flashdato/Bachelor_Project/Media/README.md

# Media — Smart Flow 2.0

This folder contains photos and video demonstrations of the physical prototype.

---

## Contents (to be uploaded)

### Prototype Photos
- `enclosure_overview.jpg` — Full assembly inside IP65 enclosure
- `sensor_module_board.jpg` — STM32 Sensor Module Blue Pill with wiring
- `relay_module_board.jpg` — STM32 Relay Module with 8-channel relay board
- `esp32_wiring.jpg` — ESP32 module and UART connections
- `solenoid_valves.jpg` — Zone solenoid valves installed on irrigation manifold
- `stepper_motor_assembly.jpg` — Fertilizer mixing valve with stepper motor
- `tds_ph_probes.jpg` — TDS and pH probes installed in-line
- `power_system.jpg` — 12V power rails, buck converters, battery

### Video Demonstrations
- `demo_relay_switching.mp4` — All 11 relay channels tested via serial terminal
- `demo_irrigation_sequence.mp4` — Full 13-state irrigation sequence running on bench
- `demo_tds_feedback.mp4` — TDS readings updating in real-time while fertilizer pump adjusts
- `demo_mqtt_control.mp4` — MQTT command from mobile triggering relay via ESP32 → STM32

---

## Photo Guidelines

When adding photos:
- Include a ruler or reference object for scale where possible
- Label boards clearly (sticky label or printed overlay)
- Capture both overview shots and detail close-ups of wiring
- Good lighting — avoid shadows on connector pins

---

## Video Guidelines

- Record serial terminal output alongside hardware where possible
- Keep videos under 2 minutes each
- Add audio commentary or on-screen text labels for what each step demonstrates
