flashdato/Bachelor_Project/Manual_Uploads/README.md

# Manual Uploads — Thesis Document Versions

This folder contains snapshots of the thesis document at different stages of development.

---

## Files

| File | Date | Description |
|---|---|---|
| **[Bachelor_Project.docx](Bachelor_Project.docx)** | June 2026 | **Final submitted version** — complete thesis with abstract, all chapters, tables, code appendices |
| [bachelor project 27.07.2026 test.docx](bachelor%20project%2027.07.2026%20test.docx) | June 2026 | Pre-final formatting test |
| [Bachelor_Project_28.06.2026.docx](Bachelor_Project_28.06.2026.docx) | May 2026 | Late draft — all chapters present, humanization pass complete |
| [Bachelor_Project_07.03.2026.docx](Bachelor_Project_07.03.2026.docx) | March 2026 | Early draft — initial structure and Chapter 1 only |
| [PDF/Bachelor_Project_28.06.2026.pdf](PDF/Bachelor_Project_28.06.2026.pdf) | May 2026 | PDF export of May draft |

---

## Document Structure (Final Version)

- **Abstract** — 300-word project overview
- **Chapter 1 — Introduction** — background, objectives, scope
- **Chapter 2 — Literature Review** — commercial systems, academic prototypes, microcontroller comparison
- **Chapter 3 — System Architecture** — hardware overview, power, communication protocol, sensors, actuators
- **Chapter 4 — Implementation** — Sensor Module firmware, Relay Module firmware, ESP32 design, mobile app, weather engine, fertilizer control
- **Chapter 5 — Testing and Evaluation** — test methodology, TDS accuracy results, communication reliability, cost breakdown, discussion, limitations
- **Conclusion**
- **References** (15 IEEE-format citations)
- **Appendix A** — Sensor Module firmware listings (full source)
- **Appendix B** — Relay Module firmware listings (full source)
- **Appendix C** — ESP32 architecture design specification

---

> The live Google Docs working copy was used during writing. This folder contains the exported final and archived versions.
