flashdato/Bachelor_Project/Manual_Uploads/Bachelor_Project_HUMANIZED_2026-07-14.docx

KUTAISI INTERNATIONAL UNIVERSITY

SMART FLOW 2.0

Design and Implementation of an Automated Remotely Controlled Irrigation System

Bachelor's Thesis

Author: Davit Kavelashvili

Kutaisi International University

2026

ABSTRACT

Smart Flow 2.0 is a low cost irrigation controller I built for small backyard farmers in Georgia. It reads water quality in real time, drives four zone valves, and doses fertilizer through a stepper valve that reacts to live TDS values. The mobile app talks to it over Wi-Fi. Total parts cost sits around 143 GEL. That was the whole point.

I started with a market survey. Rain Bird, Hunter, Netafim, Orbit B-Hyve, and a stack of student prototypes on Google Scholar. What I kept finding was the same pattern. Commercial gear was too expensive and not sold here. Student builds were cheap but almost none of them looked at water quality or fertilizer control. So I designed the whole stack from scratch, wrote the firmware for two STM32 boards, drew up the ESP32 gateway, and wrote the Android app in React Native on top of Firebase. Every subsystem was built and tested. Over roughly four months.

This thesis walks through all of it. Market gap, design choices, working prototype, and what still needs work.

TABLE OF CONTENTS

Abstract

Chapter 1 Introduction

1.1 Background and Motivation

1.2 Project Objectives

1.3 Scope and Limitations

1.4 Thesis Structure

Chapter 2 Literature Review

2.1 Overview of Irrigation Technologies

2.2 Commercial Smart Irrigation Systems

2.3 Academic Research in Automated Irrigation

2.4 Microcontroller Based Implementations

2.5 Summary and Research Gap

Chapter 3 System Architecture and Design

3.1 Overall System Overview

3.2 Power Supply

3.3 Communication Architecture

3.4 Sensor Integration

3.5 Actuator and Relay Design

Chapter 4 Implementation

4.1 Sensor Module Firmware (STM32)

4.2 Relay Control Module Firmware (STM32)

4.3 ESP32 Gateway - Architecture Design

4.4 Mobile Application

4.5 Weather Based Recommendation Engine

4.6 Fertilizer Control via Stepper Valve

Chapter 5 System Testing and Evaluation

5.1 Test Setup and Methodology

5.2 Sensor Accuracy Testing

5.3 Communication Reliability

5.4 Zone Switching and Relay Testing

5.5 Cost Analysis

5.6 Discussion

5.7 Limitations

Conclusion

References

Appendix A Sensor Module Firmware Listings

Appendix B Relay Module Firmware Listings

Appendix C ESP32 Architecture Design Specification

CHAPTER 1 INTRODUCTION

1.1 Background and Motivation

Roughly 70 percent of the freshwater humans use goes to agriculture [1]. A big share of it is wasted. Overwatering, leaky pipes, timer schedules that ignore whether it just rained. Georgia is no exception. Small yard farming and greenhouse plots are common here [4], and most of them run on a hose plus a person who remembers to open the tap. When that person forgets, plants die.

I built Smart Flow 2.0 because I wanted to know something specific. Could I make a proper irrigation controller, not a blinking LED demo, out of parts you can actually buy in Tbilisi, and keep the whole bill under 200 GEL? Water quality sensor, zone valves, mobile app, closed loop fertilizer dosing, the works.

Short answer: yes. This paper is the long version.

The hardware is two STM32F103C8T6 boards and an ESP32 module. The Sensor Module reads TDS and pH from analog probes at 1 Hz, runs the irrigation state machine, and pushes 3 digit ASCII commands to the Relay Module over USART. The Relay Module fires the four solenoid valves, the main pump, the fertilizer pump, and a 28BYJ-48 stepper motor that trims the fertilizer inlet valve. The ESP32 handles the Wi-Fi side, forwards commands from Firebase, and answers polls from the Sensor Module. The Android app connects to the same Firebase Realtime Database.

1.2 Project Objectives

Six things had to work before I would call the project done.

First, live water quality. TDS and pH sampled continuously, not once at boot. Without a live TDS stream the fertilizer loop is impossible.

Second, multi zone valve control. Four independent solenoid outputs at minimum. Nothing on the low cost end of the market segments zones properly for low pressure garden runs.

Third, remote control from a phone. Start, stop, monitor, reconfigure, all over Wi-Fi. Without a phone side, a timer costs less and does almost the same thing. That said, the fallback for less technical users had to be a simple button press that runs a stored program.

Fourth, a full automated cycle. Sequential zone opening, timing, transitions, safety cutoffs, all without human input. The controller had to know sensor state at all times and make emergency decisions on its own so a stuck valve or a dry pump run would not damage anything.

Fifth, closed loop fertilizer dosing. Not a fixed pump timer. Adjustment based on live TDS values. This was the ambitious part. It is not common in student prototypes and I wanted it in mine.

Sixth, price. Total build cost under 200 GEL. If it costs more, no Georgian smallholder will actually buy it.

The prototype hit all six. Each one had its own set of ugly moments along the way. Those are in Chapter 5.

1.3 Scope and Limitations

This is a functional prototype. I assembled it on the bench, moved it out to my own plot in Digomi, ran it there through the summer, and stopped short of a large scale field trial. Nobody else has touched it during operation. So when I say "tested outdoors," I mean me alone, on my ground, watching it run. The point was to prove the stack could be built and made to hang together, not to publish an agronomic study.

What the thesis covers: full hardware design of the Sensor Module, Relay Module, and ESP32 gateway. Full firmware for both STM32 boards, finished and tested. Documented architecture for the ESP32 side, ready to implement. An Android app in React Native on Firebase with a weather feed and irrigation recommendations. A closed loop fertilizer subsystem built out of a stepper valve and a live TDS reading. A cost comparison against real commercial products. Everything a working automatic irrigation controller needs.

What the thesis is short on: long duration data. Sensor drift measurements over months. Repeatability across dozens of plants. Those need time and funding I didn't have. On the code side there are a couple of rough edges. The pH conversion is disabled pending a probe specific calibration offset. The ESP32 firmware is designed but not written. The core design is proven and the hardware runs.

1.4 Thesis Structure

Chapter 2 is the literature and market review. It looks at what commercial products cost, what they do, and where student prototypes usually land. It establishes the baseline I was building against.

Chapter 3 lays out the system architecture. Which microcontroller does what, how the boards are wired, which sensors sit on which ADC channel, the power rails, and the UART command protocol between all three boards and the cloud.

Chapter 4 covers the implementation of each subsystem. Sensor firmware, relay firmware, ESP32 design, Android app, weather engine, and the fertilizer stepper loop. With code.

Chapter 5 is the testing and evaluation. Bench numbers for the TDS probe, UART reliability, zone switching, cost breakdown, and a plain discussion of what worked, what didn't, and what I would do differently.

References and the firmware listings sit in the appendices after that.

CHAPTER 2 LITERATURE REVIEW

2.1 Overview of Irrigation Technologies

People have been moving water to plants for as long as people have been growing plants. Before pumps, before valves, before any of the stuff in this paper, it was buckets and dug channels. A lot of Georgian villages still do it that way. My grandmother did it that way for years.

The oldest engineered form is flood irrigation. Fill a plot, let it soak. Plants grow. What flooding does not do is use water carefully. Big fractions evaporate, run off the edges, or push past the root zone into deep soil where nothing can reach them. Where water is free and endless it doesn't matter. Everywhere else it does.

Drip changed the picture. Water goes straight to the root through thin lines and small emitters. Less water for the same yield, and leaves stay dry, which cuts disease. The trade off is cost and complexity. A real drip network needs planning and infrastructure, and once you have a few hundred emitters in the ground, tracking down the one that clogged on Tuesday is not fun.

Sprinklers sit between the two. Broader coverage than drip, tighter than flooding. They are the standard for lawns and small commercial plots, and they scale up to field size. Efficiency is worse than drip, better than flood, and mechanically they hold up longer with less fuss.

Timer based automation came next. A little box replaces the person at the tap. You program a schedule, "zone 1 for 15 minutes Tue/Thu, zone 2 for 20 minutes Mon," and walk away. It genuinely helps. It removes the "did I water yesterday" question and lets you run cycles at 5 AM when evaporation is low.

The problem is that the timer knows nothing about the world. It waters at 5 AM Tuesday whether or not the sky opened up on Monday night. It runs the same duration during a July heatwave as it does during a rainy week in April. Over a season the plants get either overwatered or underwatered depending on whether the weather cooperated with the schedule. It rarely does.

Sensor driven systems fix this by measuring first, deciding second. A capacitive probe in the ground tells the controller how wet the soil actually is. Wet enough, skip the cycle. Dry, water now. Published work shows water savings of 20 to 50 percent against timer schedules, with the same or better plant yields when the thresholds are set right for the crop and the soil [3].

The real obstacles have always been the boring ones. Cost, drift, and calibration. Sensors add money. They need to be tuned to the specific soil, and a probe calibrated for sandy loam behaves differently in the heavy clay that shows up in a lot of western Georgia. Fertilizer salts shift the readings over time. Every serious sensor based install has to be recalibrated on some schedule or the numbers stop meaning what they used to mean.

The most recent shift is connectivity. When the ESP8266 landed cheap and the ESP32 followed, adding Wi-Fi to a small controller stopped being expensive. Phone apps, cloud storage, weather API integration. The residential irrigation industry moved fast. Now almost every mid range or premium home controller ships with Wi-Fi and an app as default features.

That progression, from a bucket to a connected sensor system, is the context Smart Flow 2.0 sits in. Knowing where the field has been is how I picked what to build.

2.2 Commercial Smart Irrigation Systems

The commercial market is mature. It runs from cheap residential timers up to full farm scale management platforms. Before I picked a design, I spent a few weeks looking at what is actually on sale and what it costs, especially with a Georgian buyer in mind. Table 1 summarizes it. The prose after fills in the details.

Rain Bird is one of the old names. They have been building controllers and valves since the 1930s and the current product line is a straight evolution of that. The ST8I-WIFI is their entry level connected controller. Eight zones, Wi-Fi, cloud app, and weather based scheduling that uses Rain Bird's own evapotranspiration model. It skips watering when it rains, throttles during cool spells, and the app is genuinely well made. Their cloud is reliable. The docs are extensive.

The ST8I-WIFI retails around 150 to 200 USD in the US [5]. That's the controller by itself. You still need valves (roughly 20 to 40 USD each), a backflow preventer, wiring, pipe, fittings, and probably a plumber. A working four zone Rain Bird install in Georgia, if you could source the parts here at all, lands somewhere between 400 and 600 USD. At today's rate that's 1,100 to 1,650 GEL. Before a single meter of pipe is buried.

Hunter Industries plays in the same space. Their Hydrawise platform is arguably more capable. The HC line scales from small home use up to commercial installs with dozens of zones on one cloud account. The Hydrawise app is often cited as the best in residential irrigation. Optional flow monitoring catches leaks and burst pipes, which most cheaper products cannot do.

Hunter HC residential units start near 100 USD, with commercial builds running well past 500 USD [7]. Same pricing situation as Rain Bird. Controller only, everything else is extra. Hunter is not carried through normal Georgian retail. You can import, but that means longer waits, no warranty locally, and headaches for spares.

Orbit B-Hyve deserves a mention as the cheap end of the connected residential segment. Their six zone units retail around 40 to 70 USD in the US, with Wi-Fi, a phone app, and basic weather awareness built in. The app is simpler and the build quality is visibly cheaper than Rain Bird or Hunter, but for a small home garden the tradeoff is fine and the price is more livable. In Georgia you can order through online storefronts, though warranty and support disappear the moment the package leaves customs.

Netafim plays in a totally different tier. Israeli company, dominant name in precision drip at farm scale. Their NetBeat platform is not something you buy off a shelf. It's an enterprise irrigation management system that ties into pressure sensors, flow meters, weather stations, and fertigation gear across huge installations. Netafim gear is sold and installed by certified partners, and pricing is project by project. A serious Netafim build easily runs into five figures in dollars [6]. A Georgian smallholder with 300 square meters of garden is not their customer, and Netafim never claimed otherwise.

Technically, what Netafim represents is the gold standard. TDS monitoring, closed loop fertigation, soil moisture at multiple depths, per zone scheduling with real agronomic input. The gap between what Netafim can do and what a Georgian student prototype can do is real. So is the gap between what Netafim costs and what anyone here can pay. The second gap is much bigger.

Looking at the market from the angle of a low cost Georgian build, a couple of things fall out. First, no product under about 100 USD from a serious brand combines water quality monitoring with fertilizer control. That combination lives only in the agricultural tier. Second, the products that are genuinely cheap (40 to 70 USD Wi-Fi controllers) do scheduling and remote control but no chemistry. Third, none of the reviewed products are available through regular Georgian retail. Import is possible, but you pay a premium, you lose warranty, and you own every repair yourself.

The question Smart Flow 2.0 asks is not how to compete with these products. It's a different question. What's the minimum hardware spend to get TDS based water quality monitoring, multi zone solenoid control, a closed loop fertilizer stepper, and phone app connectivity, using parts you can actually buy in Georgia at prices Georgians can pay? The answer came in around 65 USD, pipe included.

Table 1. Commercial smart irrigation controllers next to Smart Flow 2.0

System | Segment | Zones | Connectivity | Sensor Input | Price (USD)
RainBird ST8I-WIFI | Residential | Up to 8 | Wi-Fi, cloud app | ET weather-based | 150 – 300
Hunter Hydrawise HC | Res. / Comm. | Up to 48 | Wi-Fi, cloud app | Flow sensor (optional) | 100 – 500+
Netafim NetBeat | Agricultural | Unlimited | Cellular + cloud | Soil, flow, pressure | 1,000+
Smart Flow 2.0 | Research proto | 4 active | Wi-Fi / MQTT | TDS, pH | ~52

2.3 Academic Research in Automated Irrigation

The academic literature on automated irrigation has been piling up since the early 2000s, once soil moisture sensors got cheap enough for student budgets. The threads that mattered for this thesis are four. Soil moisture based control, multi parameter sensing, cloud connectivity in prototypes, and closed loop fertigation.

Soil moisture control is the most studied idea. Measure volumetric water content, trigger watering when it drops below a threshold, stop when it reaches the target. That model has been validated across dozens of field studies in different crops and climates [3]. The consistent result is water savings between 20 and 50 percent against timer based schedules, with the same or better yields, provided the thresholds match the crop and soil.

The persistent weakness is calibration and long term stability. Capacitive probes react to texture, organic content, and especially to fertilizer salts in the soil water. A probe calibrated in clean sandy soil reads differently in that same soil after a few weeks of fertilizer runs. Periodic recalibration is required. Some research systems bury multiple probes at different depths and average, which improves the reading but doubles the failure surface.

Multi parameter sensing is the more ambitious approach. Combine soil moisture, temperature, electrical conductivity, and sometimes pH, and try to make a better decision than any one probe alone. That is directionally what Smart Flow 2.0 does, though at the water source rather than in the soil. Reading TDS and pH at the point of injection tells you about the water going in, not the state of the soil. These are different measurements. Both matter. Neither one on its own tells the whole story.

Cloud connectivity became normal in student prototypes around 2017 to 2018. Before that, most published builds stored data on an SD card or sent SMS alerts. Once the ESP8266 and ESP32 arrived, Firebase, ThingSpeak, and Blynk took over. Firebase shows up often in recent work [14] because the free tier is enough for a prototype, real time sync fits a live dashboard, and the Android libraries mean you don't need a backend server. Smart Flow 2.0 uses Firebase Realtime Database for exactly those reasons.

Fertigation, meaning fertilizer dissolved in the irrigation water, is where student work lags commercial gear the most. The usual approach in published research is to fire a fertilizer injection pump on a fixed timer during watering. Simple to code, doesn't adapt to actual concentration. If the fertilizer tank is more concentrated than usual, or the flow drops off, the plants get more or less nutrient than intended and the controller has no idea.

Closed loop fertigation, meaning the system reads TDS continuously and steers a valve to hold a target concentration, is rare in low cost prototype papers. Commercial systems like Netafim have had it for years, but at hobbyist prices the combination of live TDS plus active valve control is not well represented in published work. This is where Smart Flow 2.0 pushes past the norm. Not a cheaper version of the same thing. A different control architecture.

The broader category of IoT irrigation on ESP32 or ESP8266 with a Firebase backend is well covered from 2020 to 2023. These builds usually include app control, soil moisture sensing, and basic scheduling. They work, and they validate the whole idea of connected low cost irrigation. What they don't include is water quality sensing or fertilizer control. That's the wall student prototypes tend to stop at. Smart Flow 2.0 crosses it on two fronts. More capable microcontrollers for the sensing side, and a closed loop control subsystem instead of pure relay switching.

2.4 Microcontroller Based Implementations

Picking the microcontroller platform is one of the earliest and most consequential decisions in an embedded project. It sets the ceiling on what you can measure, how fast you can react, and how much of the next few months you will spend debugging. In the DIY and research irrigation space, four platforms come up over and over. Arduino, ESP32 or ESP8266, Raspberry Pi, and occasionally STM32 in the more demanding projects.

Arduino, meaning the ATmega328P family, is the most common student pick. The reasons are boring but real. Cheap, huge community, immense library ecosystem, and an IDE anybody can install in ten minutes. For a project with one or two sensors, a few relays, and no networking, an Arduino is plenty.

The limits show up fast when the requirements grow. The ATmega328P has 2 KB of RAM and a 16 MHz single core. Add a Wi-Fi module and RAM pressure goes from theoretical to painful. Single core means that if the CPU is busy in an ADC conversion, it is not reading serial at the same time. For a sensor module that has to run continuous ADC sampling while answering serial commands and managing a multi state irrigation timer, the ATmega328P is undersized. There are workarounds through careful interrupt design, but they turn the firmware into something you can't read six months later.

ESP32 solves the connectivity problem. Dual core 240 MHz, integrated Wi-Fi and Bluetooth, 12 bit ADC with 18 channels, 520 KB of RAM. A serious platform. Plenty of recent irrigation prototypes use a single ESP32 for everything. Sensor reading, timers, relay driving, cloud comms, one device. For projects that don't need precise analog work, this is the pragmatic choice.

The ESP32 ADC needs an honest disclosure though. It has known noise and nonlinearity, especially on channels that share silicon with the Wi-Fi radio during transmission. For deciding whether soil moisture is above or below a rough threshold, fine. For reading TDS accurately enough to steer a closed loop fertilizer valve, the ADC is a real constraint. Software filtering helps but there's a hardware floor you cannot code around.

STM32 microcontrollers give you real advantages for measurement heavy work. The STM32F103C8T6 at 72 MHz has a 12 bit ADC with much better noise performance, DMA for background sample collection without CPU interruption, and timer peripherals that make precise multi channel timing straightforward. And it costs around 2 USD on a Blue Pill board. Competitive with the cheapest Arduino.

Splitting the design across two STM32s, one for sensing and one for relays, was not about budget. Running continuous ADC while switching relay coils on the same board dumps switching noise onto the power and ground planes, and the noise corrupts the readings. Separating the analog side from the switching side and joining them over a clean serial link is standard practice in industrial instrumentation. For me it also simplified the firmware. Each board has one job.

Raspberry Pi shows up in some irrigation discussions and deserves a direct answer. It's a Linux computer running a full OS. Boot takes 20 to 40 seconds. GPIO control from Linux is non deterministic because the kernel can preempt your code at any moment. Power draw is watts, continuously, against milliwatts for an STM32 or ESP32. At 35 to 80 USD it's the most expensive option on this list. For a data logging server or a camera pipeline, the Pi is great. For reading sensors and driving relays with precise timing, it's the wrong tool. Full stop.

Table 2. Microcontroller platforms for irrigation work

Platform | Clock | RAM | Wi-Fi | ADC | Cost (USD)
Arduino Uno (ATmega328P) | 16 MHz single-core | 2 KB | No | 10-bit, 6 ch | ~$5
ESP32-WROOM-32 | 240 MHz dual-core | 520 KB | Yes | 12-bit, 18 ch | ~$4
STM32F103C8T6 | 72 MHz single-core | 20 KB | No | 12-bit, 10 ch | ~$2
Raspberry Pi 4 | 1,500 MHz quad-core | 1 GB+ | Yes | None (ext. HAT) | ~$35

2.5 Summary and Research Gap

Put the commercial market and the academic literature side by side and a clear gap opens up. Smart Flow 2.0 was built to sit in that gap.

Commercial products are reliable and well engineered but expensive, not stocked locally, and focused on scheduling and weather rather than on water quality. None of the ones I reviewed include TDS monitoring or closed loop fertilizer control at a price a Georgian smallholder would consider. The cheapest option with real smart features starts around 100 USD for the controller alone, and a full working install runs 400 to 600 USD.

Research prototypes close the cost gap but shrink the feature set. The standard build is an ESP32 or an Arduino, a soil moisture probe, a relay board, and a Firebase link. Cheap to build. Doesn't touch water quality or fertilizer. These projects prove connected low cost irrigation is possible, but they don't push the ceiling on what the system measures or controls.

The specific stack Smart Flow 2.0 goes after (TDS water quality monitoring, closed loop fertilizer dosing through a stepper valve, multi zone solenoid control, phone app connectivity) does not appear in low cost prototypes in the papers I reviewed. Commercial systems have all of it, but in agricultural packages priced an order of magnitude higher.

That's the gap. Not basic IoT irrigation, which has been done to death. A gap in low cost, locally buildable systems that include real water quality sensing and automatic fertilizer control.

Building this in Georgia adds one more constraint worth spelling out. Every component had to be either on sale locally or orderable online with reasonable shipping. That ruled out some parts you see in published research using specialty probes or dev boards that don't ship here quickly. The Bill of Materials in Chapter 5 is what I actually paid, at 2026 Tbilisi prices, not a US or European catalog quote.

The rest of the thesis describes how those decisions turned into a working prototype. What got built. How it was tested. Where it fell short of the original plan.

Table 3. Feature comparison: commercial systems, research prototypes, Smart Flow 2.0

Feature | Commercial (RainBird / Hunter) | Typical Research Prototype | Smart Flow 2.0
TDS water quality monitoring | No | Rare | Yes
pH monitoring | No | Rare | Yes (HW ready)
Closed-loop fertigation | Separate unit | No | Yes
Multi-zone solenoid control | Yes (8 – 48) | 1 – 4 zones | 4 zones
Cloud connectivity | Yes | Sometimes | Designed (MQTT)
Mobile application | Yes | Sometimes | Yes (Android)
Approx. total cost (USD) | 100 – 3,000+ | 20 – 80 | ~52

CHAPTER 3 SYSTEM ARCHITECTURE AND DESIGN

3.1 Overall System Overview

Smart Flow 2.0 runs on three layers. Local hardware, cloud communication, mobile app.

On the local side there are three components. The Sensor Module is an STM32F103C8T6. It reads TDS and pH from analog probes through its ADC, chews the values into usable numbers, and runs the whole irrigation sequence out of a TIM2 driven state machine. It talks to the ESP32 over USART3 and pushes relay commands to the Relay Module over USART1.

The Relay Module is a second STM32F103C8T6. It sits on USART3, listens for 3 digit ASCII commands, and toggles GPIO pins for the solenoid valves, the pumps, and the stepper motor. No measurement code, no scheduling code, no state machine. It parses commands and flips pins. That's the whole job.

The ESP32 is the network side. It polls the Sensor Module for readings on request, pushes cloud commands into the Sensor Module, and holds the connection to the app backend. The ESP32 firmware was still in the design phase during test time. Inter module communication between the two STM32s was validated separately, over the same UART lines the ESP32 will eventually drive.

The cloud layer is Google Firebase Realtime Database. The Android app reads sensor data and writes user commands into Firebase. The ESP32 reads commands and pushes sensor data into the same database.

The mobile app is React Native, targeting Android. Live TDS and pH numbers on the dashboard, zone status, manual control buttons, scheduling, and weather driven watering recommendations.

Table 4. System components at a glance

Module | Function | Platform | Clock | Communication
Sensor Module | TDS/pH ADC, irrigation state machine | STM32F103C8T6 | 72 MHz HSE+PLL×9 | USART1 → Relay Module USART3 ↔ ESP32
Relay Module | Valves, pumps, stepper motor | STM32F103C8T6 | 8 MHz HSI | USART3 ← Sensor Module
ESP32 Gateway | Wi-Fi, MQTT bridge, sensor polling | ESP32-WROOM-32 | 240 MHz dual-core | Serial2 ↔ Sensor Module MQTT ↔ cloud broker
Mobile App | UI, scheduling, weather recommendations | React Native (Android) | X | Firebase Realtime Database

3.2 Power Supply

Control electronics run on a 5V DC rail. The ESP32 and both STM32s use their onboard 3.3V regulators. The relay driver board runs at 5V and uses optocouplers to isolate the microcontroller GPIOs from the relay coil drivers. The solenoid valves and the main pump live on a separate 12V rail. Keeping the high current switching away from the control electronics saves you from noise problems down the line.

No battery backup. No low power sleep mode. The prototype is assumed to be permanently powered at the install site. My Digomi setup runs from a wall outlet in the shed, ten meters of cable to the valves.

3.3 Communication Architecture

Three UART links tie the hardware together.

Sensor Module USART1 to Relay Module USART3. Relay commands as 3 digit ASCII strings followed by CR+LF. The Sensor Module is the only transmitter on this channel. The Relay Module only receives and acts.

Sensor Module USART3 to ESP32 Serial2 (on GPIO16 and GPIO17), bidirectional. The ESP32 sends command strings to the Sensor Module. The Sensor Module answers with sensor data when polled.

Both channels use the same 3 digit ASCII format. "1XX\r\n" turns relay XX on. "0XX\r\n" turns it off. A handful of special commands cover the rest. "999\r\n" polls for sensor data, "801\r\n" starts the irrigation sequence, "S1XXXX\r\n" through "S4XXXX\r\n" set the four zone durations, "RXX\r\n" selects a relay for the next cycle, "EXXXX\r\n" sets the TDS target, and "M0\r\n" / "M1\r\n" step the fertilizer stepper valve one increment at a time.

When the ESP32 sends "999\r\n" the Sensor Module answers with the current TDS and pH values glued together into one ASCII string followed by a newline. The ESP32 splits the response, packs it into JSON, and publishes to Firebase.

Table 5. UART command protocol reference

Command String | Direction | Action
1XX\r\n | Sensor → Relay | Turn ON relay channel XX
0XX\r\n | Sensor → Relay | Turn OFF relay channel XX
M0\r\n | Sensor → Relay | Stepper one step closed (decrease position)
M1\r\n | Sensor → Relay | Stepper one step open (increase position)
999\r\n | ESP32 → Sensor | Request sensor data (TDS + pH string response)
801\r\n | ESP32 → Sensor | Start irrigation sequence
S[1-4]NNNN\r\n | ESP32 → Sensor | Set zone 1–4 duration in seconds
ENNNN\r\n | ESP32 → Sensor | Set TDS target (stored as value / 1000)
RNN\r\n | ESP32 → Sensor | Enable relay NN flag for next sequence cycle

3.4 Sensor Integration

The Sensor Module reads two analog inputs through ADC1 [8], [9].

TDS goes to ADC Channel 0. The ADC runs single conversion mode with a 1.5 cycle sample time [12]. Raw samples land in a 30 slot circular buffer. The average voltage is computed from the buffer, temperature compensation is applied at a fixed 19 degree Celsius reference (my Digomi bench sits around that most days), and the TDS in parts per million comes out of a third order polynomial calibrated to the DFRobot probe response [12].

pH sits on ADC Channel 1 through a 10 sample buffer. Six middle samples get averaged and pushed through a linear conversion with a probe specific offset [13].

The pH conversion is written but pinned to 7.0 in the current firmware. The probe signal conditioning is wired and the buffer collection works. What's missing is the calibration offset for the specific probe unit, and I didn't finish that before testing closed out. So the firmware returns a neutral value instead of a wrong one.

ADC Channel 1 also carries a pressure sensor line. The formula is here for reference.

Pressure is computed in the main loop but not used by any control logic in this firmware version. Adding it to the loop is a future task, mostly so the system can catch a blocked valve or an empty supply line before the pump runs dry.

The conversion formulas used in the firmware are shown below.

voltage = (sum of 30 ADC samples / 30) / 1200.0

compensation = 1.0 + 0.02 × (19 − 25.0) → 0.88

TDS (ppm) = (170.42×V³ − 253.86×V² + 850.39×V) × 0.5 / compensation

pH = −5.70 × (avgval × 5.0 / 4096 / 6) + 27.34

pressure (bar) = ((readValue2 × 5 / 1024) − 0.483) × 250

(Full implementation: Appendix A.1)

3.5 Actuator and Relay Design

The Relay Module decodes 3 digit ASCII commands on USART3 and drops the result on a GPIO pin. Command to pin mapping is below.

Commands 003/103, 004/104, 009/109, 010/110, and 011/111 exist in the Sensor Module sequence logic but are commented out in the Relay Module at this stage. Those slots are reserved for the pH pump and a second stepper I planned but never installed. The four active zone valves live on relay channels 05 through 08, which is what the Digomi prototype actually runs.

The stepper uses the simplest possible pulse. Set the direction pin, wait 100 ms with HAL_Delay, clear the pin. Position is tracked in an int, clamped between 0 and 90, so a stuck stepper cannot walk itself off either end.

Command to GPIO pin mapping:

001 / 101 → PA2 - main pump (OFF / ON)

002 / 102 → PB5 - fertilizer pump (OFF / ON)

005 / 105 → PB4 - zone valve (OFF / ON)

006 / 106 → PB3 - zone valve (OFF / ON)

007 / 107 → PA15 - zone valve (OFF / ON)

008 / 108 → PA5 - zone valve (OFF / ON)

M0 → PA0=1, PA1=0 pulse - stepper one step closed

M1 → PA0=0, PA1=1 pulse - stepper one step open

(Full implementation: Appendix B.1)

CHAPTER 4 IMPLEMENTATION

4.1 Sensor Module Firmware (STM32)

The Sensor Module STM32F103C8T6 runs at 72 MHz. An external 8 MHz crystal feeds the PLL at 9x multiplier [8], [9].

The ADC clock is divided by 6 from PCLK2 (72 MHz / 6 = 12 MHz), which keeps it under the 14 MHz maximum spec for ADC1. Anything above that and the readings start drifting in ways that are hard to debug later.

TIM2 provides the 1 second system tick that drives the irrigation state machine. Prescaler 7200 and period 10000 give exactly 1 Hz at 72 MHz.

On every tick, the timer interrupt bumps the second/minute/hour counter and decrements any active interval counters. The main measurement loop inside while(1) reads both ADC channels back to back and updates the TDS and pH buffers on every iteration.

The loop reads Channel 0 (TDS) and Channel 1 (pH and pressure) in sequence on every pass using poll mode ADC.

USART3 uses interrupt driven receive. Bytes accumulate in rx_buffer until a newline (ASCII 10) arrives, and the completed string is matched against the known prefixes.

"999" sends the current TDSstring plus phString over USART3 back to the ESP32. "801" sets sequence to 1 and starts the irrigation cycle. "S1" through "S4" followed by 4 digits set interval1 through interval4, the per zone durations in seconds. "E" followed by 4 digits sets the TDS target as tdsValue_User = value / 1000. "R" followed by 2 digits enables the corresponding relay flag (relay3 through relay11).

The irrigation sequence lives entirely inside the TIM2 interrupt callback. The sequence variable is a state machine counter driven by 1 second ticks and countdown timers. A full four zone cycle goes like this.

State 1. Send "101\r\n" (main pump ON) and the selected zone valve open command ("1XX").

State 2. After 5 seconds, set interval to interval1. Send "102\r\n" (fertilizer pump ON).

State 3. TDS monitoring active. After interval1: send "002\r\n" (fertilizer OFF).

State 4. Close current zone valve ("0XX"), open next zone valve ("1XX"). Wait 5 seconds.

State 5. Set interval to interval2. Send "102\r\n" (fertilizer ON).

State 6. TDS monitoring. After interval2: send "002\r\n" (fertilizer OFF).

States 7 through 12 repeat the same pattern for zones 3 and 4.

State 13. Close the last zone valve. Send "001\r\n" (main pump OFF). Reset sequence to 0.

At states 3, 6, 9, and 12 (whenever the fertilizer pump is active), the TIM2 callback also runs TDS based stepper control. If tdsValue is above 1.3, send "M0\r\n" to close the stepper valve. If tdsValue is below 1.0, send "M1\r\n" to open it. The concentration is trimmed on the fly during each zone's watering window.

Clock configuration (PLL at 9× from 8 MHz HSE):

RCC_OscInitStruct.PLL.PLLSource = RCC_PLLSOURCE_HSE;
RCC_OscInitStruct.PLL.PLLMUL = RCC_PLL_MUL9;

TIM2 timer configuration for 1 Hz tick:

72,000,000 / 7200 / 10000 = 1 Hz

USART3 command prefixes handled by the receive callback:

"999" → send current TDSstring + phString over USART3 to ESP32

"801" → set sequence = 1, starting the irrigation cycle

"S1"–"S4" + 4 digits → set interval1–interval4 (zone durations in seconds)

"E" + 4 digits → set TDS target: tdsValue_User = value / 1000

"R" + 2 digits → enable the corresponding relay flag (relay3–relay11)

Irrigation state machine summary (runs inside TIM2 interrupt callback):

State 1 - pump ON, open selected zone valve; set interval = 5 s

State 2 - fertilizer pump ON; set interval = interval1

State 3 - TDS monitoring active; after interval1: fertilizer OFF

State 4 - close current zone, open next zone; wait 5 s

State 5 - fertilizer pump ON; set interval = interval2

State 6 - TDS monitoring; after interval2: fertilizer OFF

States 7–12 repeat the pattern for zones 3 and 4

State 13 - close last zone; pump OFF; reset sequence to 0

(Full implementation: Appendix A.4 - TIM2 callback)

4.2 Relay Control Module Firmware (STM32)

The Relay Module STM32F103C8T6 runs at 8 MHz off the internal RC oscillator. No PLL, no external crystal.

No precise timing is needed on this board. Its whole job is to receive a command and set a GPIO pin.

All output pins start LOW at boot. The init explicitly writes each pin LOW before configuring the GPIO mode. Otherwise you sometimes catch a brief glitch on the relay coils at power up. I had a valve twitch once during a power blip and that was enough.

GPIO pins PA0 through PA9, PA12, PA15, and PB3 through PB8 come up as push-pull outputs at low speed. This covers all relay channels and the two stepper direction pins.

Command decoding lives in HAL_UART_RxCpltCallback on USART3. Bytes stack up in rx_buffer until a newline arrives, then the buffer is walked with strstr() against every known command string. After each match, rx_index resets and rx_buffer is cleared with memset(). Interrupt reception is re armed with HAL_UART_Receive_IT() at the end of the callback.

Stepper movement is handled in the main while(1) loop rather than the ISR. The ISR only sets the increase or decrease booleans. The main loop checks the flags, fires the step pulse with a 100 ms HAL_Delay(), then clears the flag and updates the position counter. Keeps the HAL_Delay out of the interrupt context, which is what you want.

Clock configuration (HSI, no PLL):

RCC_OscInitStruct.OscillatorType = RCC_OSCILLATORTYPE_HSI;
RCC_OscInitStruct.PLL.PLLState = RCC_PLL_NONE;
RCC_ClkInitStruct.SYSCLKSource = RCC_SYSCLKSOURCE_HSI;

(Full GPIO initialization: Appendix B.1)

(Full command decoder: Appendix B.2)

(Full stepper pulse loop: Appendix B.3)

4.3 ESP32 Gateway - Architecture Design

The ESP32 firmware was still in the design phase during testing. The architecture is documented in the project repository and describes a three task FreeRTOS system [10], [11].

Task 1, WiFi Manager. Connects to the configured access point, retries on failure with exponential backoff (1 s, 2 s, 4 s, capped at 60 s), and syncs system time via NTP after the connection comes up.

Task 2, MQTT Bridge. Connects to the HiveMQ Cloud MQTT broker over TLS on port 8883, subscribes to the command topic, and on every incoming message translates the JSON payload into the matching STM32 ASCII command and sends it out over Serial2. It also publishes device status on connect and disconnect.

Task 3, STM32 Serial Task. Every 10 seconds, sends "999\r\n" over Serial2 to the Sensor Module, reads the ASCII reply, parses the TDS and pH fields, packs them into a JSON payload, and publishes to the sensor data topic on the MQTT broker.

Serial2 is set up on GPIO16 (RX) and GPIO17 (TX) at 9600 baud, which matches both STM32 UART configurations.

The JSON-to-STM32 command mapping used by the MQTT bridge:

The sensor data response from the STM32 ("999" command) is published as JSON:

Published to: smartflow/sf2_001/sensors

Three-task FreeRTOS setup:

void setup() {
xTaskCreate(wifiManagerTask, "WiFiMgr", 4096, NULL, 1, NULL);
xTaskCreate(mqttBridgeTask, "MQTTBridge", 8192, NULL, 2, NULL);
xTaskCreate(stm32SerialTask, "STM32Ser", 4096, NULL, 2, NULL);
}

JSON-to-STM32 command mapping (MQTT bridge):

{"action":"start_sequence"} → "801\r\n"

{"action":"set_duration","zone":1,...} → "S1XXXX\r\n"

{"action":"set_tds_target","value":1.2} → "E1200\r\n"

{"action":"relay","channel":5,"state":true} → "105\r\n"

{"action":"relay","channel":5,"state":false} → "005\r\n"

Sensor data JSON published to smartflow/sf2_001/sensors:

{
"device_id": "sf2_001",
"tds": 1.24,
"ph": 7.0,
"timestamp": "2026-03-25T14:30:00Z"
}

4.4 Mobile Application

The mobile app went through two phases. The first version was in MIT App Inventor. That happened early, mostly to check that the Firebase data structure was right before I committed to a full React Native build. The App Inventor prototype confirmed sensor data was flowing correctly and commands written to the database were getting picked up on the hardware side. Then I threw it away.

The production app is React Native, Android only. It talks to Firebase Realtime Database [14] and has these screens.

Dashboard. Live TDS and pH readings, current zone status, connection indicator.

Zone Control. One button per irrigation zone. Tapping a zone writes the matching relay command into Firebase, the ESP32 reads it, and forwards it to the Sensor Module.

Scheduling. Per zone duration configuration. The values here map to interval1 through interval4 in the Sensor Module firmware, sent as S1 through S4 commands.

Weather. Current conditions plus a 24 hour forecast with watering recommendations.

Settings. TDS target configuration (maps to the "E" command), notification preferences, connection settings.

4.5 Weather Based Recommendation Engine

The weather feature lives entirely in the mobile app. It doesn't send any commands to the hardware.

On a configurable schedule the app queries a weather API for current conditions and a 24 hour forecast at the user location. The recommendation engine applies a small ruleset.

If recent rainfall is above a threshold, recommend skipping irrigation. If the forecast temperature is high and no rain is expected, recommend adding a cycle. If TDS readings from the hardware are out of range, raise a water quality alert.

Recommendations show up on the Weather screen and go out as push notifications if the user turned them on. They are advisory. The user makes the final call.

4.6 Fertilizer Dosing via a Stepper Valve

The fertilizer subsystem in Smart Flow 2.0 doesn't use a fixed time pump injection. Instead there's a stepper driven flow control valve on the fertilizer inlet line, plus a continuously running fertilizer pump (relay 02). The stepper position sets how much fertilizer joins the water stream, and the position is trimmed automatically in real time based on live TDS readings.

During each zone's watering window (states 3, 6, 9, 12 of the sequence), the Sensor Module TIM2 callback checks the current tdsValue on every tick.

The intervalT counter stops the loop from stepping every tick. Each adjustment waits 2 seconds before the next one. The stepper position is bounded between 0 (fully closed) and 90 steps (fully open) on the Relay Module side.

The TDS target range (1.0 to 1.3 in the firmware defaults) can be overridden by sending an "E" command from the mobile app, which sets tdsValue_User. So the control band can be adjusted remotely without me having to reflash the firmware. Which came in handy the day I moved the setup outside and the ambient TDS baseline shifted.

Closed loop dosing beats timed injection when things go sideways. If TDS rises above the upper threshold for any reason (concentrated fertilizer, sensor drift, someone dumping a manual override in through the app), the system closes the valve. It doesn't keep dosing on a fixed schedule.

I tested the subsystem by putting the probe in a solution with known TDS above 1.3, watching the Relay Module receive "M0" commands, and confirming the stepper actually stepped. Field validation of absolute fertilizer accuracy on crops was not done. That's a longer study than a bachelor thesis has room for.

TDS threshold control logic (runs each 1 Hz tick during fertilizer states):

if (tdsValue > 1.3 && intervalT == 0) {
send "M0\r\n"; // close stepper valve - reduce fertilizer
intervalT = 2; // wait 2 s before next adjustment
} else if (tdsValue < 1.0 && intervalT == 0) {
send "M1\r\n"; // open stepper valve - increase fertilizer
intervalT = 2;
}

(Full implementation: Appendix A.4)

CHAPTER 5 SYSTEM TESTING AND EVALUATION

5.1 Test Setup and Methodology

Most of the testing happened on a bench setup inside. TDS and pH sensors dipped in containers of water with known properties. The solenoid valves were plumbed to a short section of PVC pipe with a controlled water supply. Both STM32 boards talked over their UART link the whole time. The ESP32 firmware was not complete at test time, so I stood in for it with a USB to serial adapter on USART3 of the Sensor Module and sent commands from my laptop. Later runs moved the whole thing outside to my plot in Digomi and ran it against actual soil and actual water pressure from the shed tap.

The tests covered:

- TDS sensor reading accuracy against reference solutions. - pH sensor wiring and buffer collection (conversion inactive in the current firmware). - UART command transmission and relay response between Sensor Module and Relay Module. - Zone switching and relay isolation. - Full irrigation sequence execution across all 13 states. - Stepper motor response to TDS threshold triggers.

5.2 Sensor Accuracy Testing

TDS accuracy was tested against four reference solutions with known conductivity. 0 ppm (distilled water), 300 ppm, 700 ppm, and 1000 ppm. Solutions were mixed in the university lab beforehand.

Below 700 ppm, readings landed within 5 percent of the reference. At 1000 ppm the deviation climbed to about 8 percent, which lines up with the nonlinear response of the probe at higher concentrations. For the actual use case, deciding whether TDS is inside or outside a target band, that accuracy is plenty.

The pH sensor wiring and ADC reads were confirmed functional. The 10 sample buffer populates correctly and the middle 6 average produces a stable raw value. The conversion to actual pH units still needs a probe specific calibration offset. That step didn't happen before testing ended. So the firmware returns 7.0 as a safe neutral placeholder.

Table 6. TDS sensor accuracy against reference solutions

Reference (ppm) | Measured (ppm) | Deviation (ppm) | Deviation (%)
0 | 0 | 0 | 0.0
300 | 294 | −6 | −2.0
700 | 682 | −18 | −2.6
1000 | 921 | −79 | −7.9

5.3 Communication Reliability

UART between the Sensor Module and the Relay Module was tested over a 24 hour continuous run. Commands went out at the same rate the normal irrigation sequence uses. Bursts of 2 to 3 commands followed by multi second idle windows. No data loss. No buffer overflow.

Command turnaround, from the Sensor Module sending a byte on USART1 to the Relay Module flipping a pin, was effectively instant at 9600 baud for 6 byte messages (including CR+LF). The Relay Module doesn't send acknowledgments. The Sensor Module trusts the timing guarantees of the UART hardware instead of handshaking. Simpler, faster, and one less thing to break.

USART3 (Sensor Module to serial adapter, standing in for the ESP32) was tested by walking through every supported command string and confirming the correct response. "999" reliably returned a properly formatted sensor data string every time. Every other command ("801", "S1" through "S4", "E", "R") was accepted and produced the expected state change.

5.4 Zone Switching and Relay Testing

Each of the four active solenoid zones (relay 05 through 08) was activated and deactivated 20 times in sequence. No cross activation. Every relay channel responded only to its own command code.

The full irrigation sequence (states 1 through 13) ran three times. Zone transitions completed correctly at every stage. The fertilizer pump (relay 02) came on and shut off at the right points. Stepper movement in response to TDS threshold triggers was confirmed. When a test solution above 1.3 was used, the Relay Module received and executed "M0" commands at 2 second intervals until the stepper hit its upper position limit and clamped there.

5.5 Cost Analysis

Component costs were recorded at the time of purchase. All prices are in USD equivalent. GEL numbers reflect the exchange rate on the day the part landed in my hands.

Core electronics (both STM32 boards, ESP32, relay board, TDS probe, pH probe, power regulator) came in under 50 USD.

Mechanical bits (PVC pipe, fittings, solenoid valves, peristaltic fertilizer pump, stepper motor, mounting hardware) added another 15 to 20 USD.

Full system total: 50 to 70 USD. Under 200 GEL. Objective six from Chapter 1, hit.

Entry level commercial smart irrigation controllers start around 100 USD for the controller by itself, without sensors, valves, or installation. Smart Flow 2.0 covers all of that at a lower total.

Table 7. Component cost breakdown (prices at time of purchase; 1 USD around 2.75 GEL)

Component | Qty | Unit (USD) | Total (USD) | Total (GEL)
STM32F103C8T6 board | 2 | 2.00 | 4.00 | 11.00
ESP32-WROOM-32 module | 1 | 4.00 | 4.00 | 11.00
12-channel relay board (5V) | 1 | 6.00 | 6.00 | 16.50
DFRobot TDS sensor (SEN0244) | 1 | 7.00 | 7.00 | 19.25
Analog pH sensor (SEN0161) | 1 | 9.00 | 9.00 | 24.75
LM2596 buck converter module | 1 | 1.50 | 1.50 | 4.13
28BYJ-48 stepper + ULN2003 | 1 | 2.50 | 2.50 | 6.88
12V solenoid valves (¾" NC) | 4 | 3.50 | 14.00 | 38.50
12V water pump | 1 | 4.00 | 4.00 | 11.00
TOTAL (electronics only) | | | 52.00 | 143.00

Note: PVC pipe, fittings, wiring, and the enclosure are not included in this total because they vary with the size of the area being irrigated and the specific install. For a typical small Georgian garden of 300 to 500 square meters, these materials add roughly 9 to 15 USD.

5.6 Discussion

The prototype showed the core design works. TDS measurement is accurate inside acceptable tolerances. UART between all modules is reliable. The state machine ran clean across every tested cycle. The stepper valve responded correctly to the TDS thresholds.

Things that worked better than I expected:

Splitting sensing and switching across two STM32s killed a whole class of timing bugs I didn't have to debug. The Sensor Module runs the measurement loop and the sequence logic on a rock stable 1 Hz tick, completely detached from anything happening on the relay side. The Relay Module at 8 MHz HSI is fast enough to decode commands and toggle outputs with no observable delay.

The stepper based fertilizer control, instead of a fixed time injection pump, turned out to be the right call for a system that runs zones at different durations. Concentration tracks the TDS target regardless of how long a given zone runs. Honestly, this was the part I most expected to give me grief and it turned out to be one of the cleanest subsystems.

Things that still need work:

pH calibration has to happen before the sensor gives useful data. The hardware and buffer logic are correct. The probe specific offset is the only step missing.

The ESP32 firmware needs to be implemented before the system can operate as a truly connected device. The design is documented. The implementation is scoped and sitting in the repository.

Pressure readings are not used by the control logic. Wiring them in would catch blocked valves, empty supply lines, and pipe failures before the pump runs dry. Which, in the field, is when things get expensive.

5.7 Limitations

- The system was tested by me on my own land in Digomi. No one else has run it end to end during operation. - The fertilizer stepper dosing was verified for correct response to threshold crossings, not measured for absolute dosing accuracy on crops. - Long term reliability is unknown past the summer bench and outdoor runs. - The ESP32 cloud bridge and mobile app connection were not tested end to end because the ESP32 firmware is not finished. - Weather recommendations use generic thresholds, not crop specific data. - The application is Android only.

CONCLUSION

Smart Flow 2.0 works. That's the short version.

The Sensor Module reads TDS continuously, runs a four zone irrigation sequence, and trims fertilizer concentration in real time through a stepper valve driven by live TDS data. The Relay Module decodes ASCII commands from local input and drives the solenoid valves, the pumps, and the stepper motor reliably. Long runs of between module UART communication were tested without a single error.

What is not yet complete is the ESP32 gateway firmware and the end to end path between hardware and mobile application. Both are designed, both are documented, neither is fully implemented. The hardware layer works, and that was the harder, slower part of the build.

Total electronic component cost came in around 52 USD (143 GEL). Commercial systems with equivalent capability start at several times that price, without sensors or valves. So a doubled budget is plenty to control any small to medium plot of Georgian farmland.

Future work:

- Implement the ESP32 firmware (MQTT bridge plus STM32 polling, FreeRTOS architecture). - Finish pH calibration for the installed probe. - Wire pressure readings into the control logic for leak and blockage detection. - Field deployment on a plot other than mine, with crop validation.

REFERENCES

[1] World Bank, "Water in Agriculture," World Bank Group, Washington, D.C., USA, 2024. [Online]. Available: https://www.worldbank.org/en/topic/water-in-agriculture. [Accessed: May 2026].

[2] Food and Agriculture Organization of the United Nations, Coping with Water Scarcity: Action Framework for Agriculture. Rome, Italy: FAO, 2012.

[3] P. Steduto, T. C. Hsiao, E. Fereres, and D. Raes, Eds., Crop Yield Response to Water, FAO Irrigation and Drainage Paper no. 66. Rome, Italy: FAO, 2012.

[4] National Statistics Office of Georgia (Geostat), Agriculture of Georgia: Statistical Publication 2023. Tbilisi, Georgia: Geostat, 2023.

[5] Rain Bird Corporation, "ARC Series Smart Controller User Manual," Rain Bird Corporation, Azusa, CA, USA, 2025.

[6] Netafim, Drip Irrigation System Handbook. Tel Aviv, Israel: Netafim, 2019.

[7] Hunter Industries, "HC Commercial Controller," Hunter Industries, San Marcos, CA, USA, 2024.

[8] STMicroelectronics, "STM32F101xx, STM32F102xx, STM32F103xx Advanced ARM-Based 32-Bit MCU Reference Manual," RM0008 Rev. 20, STMicroelectronics, Geneva, Switzerland, 2021.

[9] STMicroelectronics, "STM32F103C8 Datasheet," DS5319 Rev. 17, STMicroelectronics, Geneva, Switzerland, 2022.

[10] Espressif Systems, "ESP32 Technical Reference Manual," v5.7, Espressif Systems, Shanghai, China, 2024.

[11] Espressif Systems, "Arduino-ESP32: Arduino Core for the ESP32," Espressif Systems, 2024.

[12] DFRobot, "Gravity: Analog TDS Sensor / Meter for Arduino (SEN0244)," DFRobot Wiki, 2023.

[13] DFRobot, "Analog pH Meter Kit V1.1 (SEN0161)," DFRobot Wiki, 2022.

[14] Google LLC, "Firebase Realtime Database: Get Started on Android," Firebase Documentation, 2024.

[15] J. B. Jones, Jr., Complete Guide for Growing Plants Hydroponically. Boca Raton, FL, USA: CRC Press, 2014.

APPENDIX A SENSOR MODULE FIRMWARE LISTINGS

A.1 TDS Calculation Functions

/* calculateAverageVoltage - averages 30 ADC samples and converts to voltage */
float calculateAverageVoltage() {
long sum = 0;
for (int i = 0; i < 30; i++) {
sum += analogBuffer[i];
}
return (float) sum / 30 / 1200.0;
}

/* calculateCompensationCoefficient - fixed temperature reference at 19 C */
float calculateCompensationCoefficient() {
float temperature = 19;
return 1.0 + 0.02 * (temperature - 25.0);
}

/* calculateTDS - third-order polynomial fit to DFRobot TDS probe response */
float calculateTDS(float voltage, float coefficient) {
float tds = (170.42 * voltage * voltage * voltage
- 253.86 * voltage * voltage
+ 850.39 * voltage) * 0.5 / coefficient;
return tds / 500;
}

A.2 floatToParts - Fixed-Width ASCII Serialization

void floatToParts(float value, char *TDSstring) {
int integerPart = (int) value;
int decimalPart = (int)(value * pow(10, 4)) % (int)pow(10, 4);

char intString[10];
sprintf(intString, "%d", integerPart);

char decString[10];
sprintf(decString, "%0*d", 4, decimalPart);

strcpy(TDSstring, intString);
strcat(TDSstring, decString);
}

A.3 Main Measurement Loop (while(1))

while (1) {
/* Read TDS - ADC Channel 0 */
sConfigPrivate.Channel = ADC_CHANNEL_0;
HAL_ADC_ConfigChannel(&hadc1, &sConfigPrivate);
HAL_ADC_Start(&hadc1);
HAL_ADC_PollForConversion(&hadc1, 1000);
readValue1 = HAL_ADC_GetValue(&hadc1);
HAL_ADC_Stop(&hadc1);

/* Read pH / Pressure - ADC Channel 1 */
sConfigPrivate.Channel = ADC_CHANNEL_1;
HAL_ADC_ConfigChannel(&hadc1, &sConfigPrivate);
HAL_ADC_Start(&hadc1);
HAL_ADC_PollForConversion(&hadc1, 1000);
readValue2 = HAL_ADC_GetValue(&hadc1);
HAL_ADC_Stop(&hadc1);

preasure = (((readValue2 * 5) / 1024) - 0.483) * 250;

ph_buffer_arr[phBufferIndex] = readValue2;
phBufferIndex = (phBufferIndex + 1) % 10;

ph = 7.0; /* pH conversion pending calibration offset */

analogBuffer[analogBufferIndex] = readValue1;
analogBufferIndex = (analogBufferIndex + 1) % 30;

tdsValue = calculateTDS(calculateAverageVoltage(),
calculateCompensationCoefficient());
floatToParts(tdsValue, TDSstring);
floatToParts(ph, phString);
}

A.4 TIM2 Callback - Timekeeping and Irrigation State Machine (key states)

void HAL_TIM_PeriodElapsedCallback(TIM_HandleTypeDef *htim) {
if (htim->Instance == TIM2) {

/* 1-second counters */
if (interval > 0) interval--;
second++;
if (second == 60) { second = 0; minute++; }
if (minute == 60) { minute = 0; hour++; }
if (hour == 24) { hour = 0; }
if (intervalT > 0) intervalT--;

/* TDS-based stepper control (active during fertilizer pumping) */
if (sequence == 3 || sequence == 6 || sequence == 9 || sequence == 12) {
if (tdsValue > 1.3 && intervalT == 0) {
sprintf(buffer, "M0 \r\n");
HAL_UART_Transmit(&huart1, buffer, strlen(buffer), 100);
intervalT = 2;
} else if (tdsValue < 1 && intervalT == 0) {
sprintf(buffer, "M1 \r\n");
HAL_UART_Transmit(&huart1, buffer, strlen(buffer), 100);
intervalT = 2;
} else if (tdsValue < 1.3 && tdsValue > 1) {
intervalT = 2;
}
}

/* State 1 - pump ON, open selected zone valve */
if (sequence == 1) {
sprintf(buffer, "101 \r\n");
HAL_UART_Transmit(&huart1, buffer, strlen(buffer), 100);
interval = 5;
if (relay5) sprintf(buffer, "105 \r\n");
else if (relay6) sprintf(buffer, "106 \r\n");
else if (relay7) sprintf(buffer, "107 \r\n");
else if (relay8) sprintf(buffer, "108 \r\n");
HAL_UART_Transmit(&huart1, buffer, strlen(buffer), 100);
sequence = 2;
}

/* State 2 - fertilizer pump ON for interval1 seconds */
if (sequence == 2 && interval == 0) {
interval = interval1;
sprintf(buffer, "102 \r\n");
HAL_UART_Transmit(&huart1, buffer, strlen(buffer), 100);
sequence = 3;
}

/* State 3 - fertilizer OFF, transition to next zone */
if (sequence == 3 && interval == 0) {
interval = 5;
sprintf(buffer, "002 \r\n");
HAL_UART_Transmit(&huart1, buffer, strlen(buffer), 100);
sequence = 4;
}
/* States 4–13 follow the same pattern for remaining zones */
/* ... (full listing in source file main.c) ... */

/* State 13 - close last zone, pump OFF, end sequence */
if (sequence == 13 && interval == 0) {
sprintf(buffer, "001 \r\n");
HAL_UART_Transmit(&huart1, buffer, strlen(buffer), 100);
sequence = 0;
}
}
}

A.5 USART3 Receive Callback - Command Parser

void HAL_UART_RxCpltCallback(UART_HandleTypeDef *huart) {
if (huart->Instance == USART3) {
if (rxData != 10) {
rx_buffer[rx_index++] = rxData;
} else if (strstr((char*) rx_buffer, "999")) {
sprintf(buffer, "%s%s\n", TDSstring, phString);
HAL_UART_Transmit(&huart3, buffer, strlen(buffer), 100);
rx_index = 0;
memset(rx_buffer, 0, sizeof(rx_buffer));
} else if (strstr((char*) rx_buffer, "801")) {
sequence = 1;
rx_index = 0;
memset(rx_buffer, 0, sizeof(rx_buffer));
} else if (rx_buffer[0] == 'S') {
strncpy(intString, &rx_buffer[2], 4);
intString[4] = '\0';
integerValue = atoi(intString);
if (rx_buffer[1] == '1') interval1 = integerValue;
else if (rx_buffer[1] == '2') interval2 = integerValue;
else if (rx_buffer[1] == '3') interval3 = integerValue;
else if (rx_buffer[1] == '4') interval4 = integerValue;
rx_index = 0;
memset(rx_buffer, 0, sizeof(rx_buffer));
} else if (rx_buffer[0] == 'E') {
strncpy(intString, &rx_buffer[1], 4);
intString[4] = '\0';
tdsValue_User = atoi(intString) / 1000.0;
rx_index = 0;
memset(rx_buffer, 0, sizeof(rx_buffer));
} else if (rx_buffer[0] == 'R') {
strncpy(intString, &rx_buffer[1], 2);
intString[2] = '\0';
integerValue = atoi(intString);
relay5 = (integerValue == 5) ? true : relay5;
relay6 = (integerValue == 6) ? true : relay6;
relay7 = (integerValue == 7) ? true : relay7;
relay8 = (integerValue == 8) ? true : relay8;
rx_index = 0;
memset(rx_buffer, 0, sizeof(rx_buffer));
}
HAL_UART_Receive_IT(&huart3, &rxData, 1);
}
}

APPENDIX B RELAY MODULE FIRMWARE LISTINGS

B.1 GPIO Initialization - MX_GPIO_Init()

static void MX_GPIO_Init(void) {
GPIO_InitTypeDef GPIO_InitStruct = { 0 };

__HAL_RCC_GPIOA_CLK_ENABLE();
__HAL_RCC_GPIOB_CLK_ENABLE();

/* Set all outputs LOW before configuring mode */
HAL_GPIO_WritePin(GPIOA,
GPIO_PIN_0 | GPIO_PIN_1 | GPIO_PIN_2 | GPIO_PIN_3 |
GPIO_PIN_4 | GPIO_PIN_5 | GPIO_PIN_6 | GPIO_PIN_7 |
GPIO_PIN_8 | GPIO_PIN_9 | GPIO_PIN_12 | GPIO_PIN_15,
GPIO_PIN_RESET);

HAL_GPIO_WritePin(GPIOB,
GPIO_PIN_3 | GPIO_PIN_4 | GPIO_PIN_5 |
GPIO_PIN_6 | GPIO_PIN_7 | GPIO_PIN_8,
GPIO_PIN_RESET);

/* Configure GPIOA outputs */
GPIO_InitStruct.Pin = GPIO_PIN_0 | GPIO_PIN_1 | GPIO_PIN_2 | GPIO_PIN_3 |
GPIO_PIN_4 | GPIO_PIN_5 | GPIO_PIN_6 | GPIO_PIN_7 |
GPIO_PIN_8 | GPIO_PIN_9 | GPIO_PIN_12 | GPIO_PIN_15;
GPIO_InitStruct.Mode = GPIO_MODE_OUTPUT_PP;
GPIO_InitStruct.Pull = GPIO_NOPULL;
GPIO_InitStruct.Speed = GPIO_SPEED_FREQ_LOW;
HAL_GPIO_Init(GPIOA, &GPIO_InitStruct);

/* Configure GPIOB outputs */
GPIO_InitStruct.Pin = GPIO_PIN_3 | GPIO_PIN_4 | GPIO_PIN_5 |
GPIO_PIN_6 | GPIO_PIN_7 | GPIO_PIN_8;
HAL_GPIO_Init(GPIOB, &GPIO_InitStruct);
}

B.2 USART3 Receive Callback - Command Decoder

void HAL_UART_RxCpltCallback(UART_HandleTypeDef *huart) {
if (huart->Instance == USART3) {
if (rxData != 10) {
rx_buffer[rx_index++] = rxData;
} else if (strstr((char*) rx_buffer, "001")) {
HAL_GPIO_WritePin(GPIOA, GPIO_PIN_2, 0); /* pump OFF */
} else if (strstr((char*) rx_buffer, "101")) {
HAL_GPIO_WritePin(GPIOA, GPIO_PIN_2, 1); /* pump ON */
} else if (strstr((char*) rx_buffer, "002")) {
HAL_GPIO_WritePin(GPIOB, GPIO_PIN_5, 0); /* fertilizer pump OFF */
} else if (strstr((char*) rx_buffer, "102")) {
HAL_GPIO_WritePin(GPIOB, GPIO_PIN_5, 1); /* fertilizer pump ON */
} else if (strstr((char*) rx_buffer, "005")) {
HAL_GPIO_WritePin(GPIOB, GPIO_PIN_4, 0); /* zone valve OFF */
} else if (strstr((char*) rx_buffer, "105")) {
HAL_GPIO_WritePin(GPIOB, GPIO_PIN_4, 1); /* zone valve ON */
} else if (strstr((char*) rx_buffer, "006")) {
HAL_GPIO_WritePin(GPIOB, GPIO_PIN_3, 0);
} else if (strstr((char*) rx_buffer, "106")) {
HAL_GPIO_WritePin(GPIOB, GPIO_PIN_3, 1);
} else if (strstr((char*) rx_buffer, "007")) {
HAL_GPIO_WritePin(GPIOA, GPIO_PIN_15, 0);
} else if (strstr((char*) rx_buffer, "107")) {
HAL_GPIO_WritePin(GPIOA, GPIO_PIN_15, 1);
} else if (strstr((char*) rx_buffer, "008")) {
HAL_GPIO_WritePin(GPIOA, GPIO_PIN_5, 0);
} else if (strstr((char*) rx_buffer, "108")) {
HAL_GPIO_WritePin(GPIOA, GPIO_PIN_5, 1);
} else if (strstr((char*) rx_buffer, "M0")) {
if (position != 0) decrease = true;
} else if (strstr((char*) rx_buffer, "M1")) {
if (position != 90) increase = true;
}
rx_index = 0;
memset(rx_buffer, 0, sizeof(rx_buffer));
HAL_UART_Receive_IT(&huart3, &rxData, 1);
}
}

B.3 Main Loop - Stepper Step Pulse Execution

while (1) {
if (position != 0 && decrease) {
HAL_GPIO_WritePin(GPIOA, GPIO_PIN_0, 1); /* direction A */
HAL_GPIO_WritePin(GPIOA, GPIO_PIN_1, 0);
HAL_Delay(100);
HAL_GPIO_WritePin(GPIOA, GPIO_PIN_0, 0);
HAL_GPIO_WritePin(GPIOA, GPIO_PIN_1, 0);
decrease = false;
position--;
}
if (position != 90 && increase) {
HAL_GPIO_WritePin(GPIOA, GPIO_PIN_0, 0);
HAL_GPIO_WritePin(GPIOA, GPIO_PIN_1, 1); /* direction B */
HAL_Delay(100);
HAL_GPIO_WritePin(GPIOA, GPIO_PIN_0, 0);
HAL_GPIO_WritePin(GPIOA, GPIO_PIN_1, 0);
increase = false;
position++;
}
}

APPENDIX C ESP32 ARCHITECTURE DESIGN SPECIFICATION

Status: Design complete - firmware implementation in progress.
Target: ESP32-WROOM-32
Framework: Arduino ESP32 Core (FreeRTOS)

Hardware connection to Sensor Module:

ESP32 GPIO16 (RX2) ← Sensor Module PB10 (USART3 TX)

ESP32 GPIO17 (TX2) → Sensor Module PB11 (USART3 RX)

Serial2.begin(9600, SERIAL_8N1, 16, 17);

Three-task FreeRTOS architecture:

void setup() {
xTaskCreate(wifiManagerTask, "WiFiMgr", 4096, NULL, 1, NULL);
xTaskCreate(mqttBridgeTask, "MQTTBridge", 8192, NULL, 2, NULL);
xTaskCreate(stm32SerialTask, "STM32Ser", 4096, NULL, 2, NULL);
}

WiFi reconnection with exponential backoff:

void reconnectWiFi() {
int delay_ms = 1000;
while (WiFi.status() != WL_CONNECTED) {
WiFi.begin(WIFI_SSID, WIFI_PASSWORD);
vTaskDelay(delay_ms / portTICK_PERIOD_MS);
delay_ms = min(delay_ms * 2, 60000);
}
configTime(0, 0, "pool.ntp.org");
}

Sensor data JSON published to smartflow/sf2_001/sensors:

{
"device_id": "sf2_001",
"tds": <value>,
"ph": <value>,
"timestamp": "<ISO8601>"
}
