flashdato/Bachelor_Project/Manual_Uploads/Bachelor_Project_07.03.2026.docx

# Smart Irrigation Systems: Global Market, Competitors, and Technical Architecture

### I. Global Market Overview

The global smart irrigation market is currently characterized by robust growth and technological transformation. As of 2025, the market is valued between $2.14 billion and $2.54 billion. It is projected to continue this upward trajectory, reaching approximately $4.15 billion by 2030 and potentially $8.44 billion by 2034. This expansion represents a compound annual growth rate (CAGR) ranging from 14.1% to 14.28%.

Key Market Drivers: The primary catalyst for this market is the global response to climate change. Smart irrigation is viewed as a critical tool for sustainability, allowing the agricultural and landscaping sectors to optimize water use amid shifting temperature patterns and unpredictable precipitation. Increasing global awareness of water conservation and the rising cost of water utilities are further accelerating adoption. In many regions, nearly 50% of water used in traditional irrigation is lost to inefficiency, creating a significant economic incentive for smart transitions.

Regional Dynamics: North America is currently the largest regional market, driven by early adoption of precision agriculture and the presence of large-scale commercial farming operations. However, the Asia-Pacific region is identified as the area with the most significant future growth potential. This is due to rapid urbanization, the development of smart cities, and an urgent need for sustainable irrigation solutions in response to inadequate rainfall.

Barriers and Challenges: Despite the positive outlook, the market faces hurdles. High initial installation costs remain a barrier for smaller agricultural producers. Furthermore, global trade relations and tariffs are impacting the supply chain, specifically increasing the costs of imported electronic components like sensors and controllers.

### II. Competitive Landscape

The competitive environment is a mix of long-standing irrigation giants and agile tech firms focusing on IoT and AI integration.

Top Tier Global Players: The market is dominated by several key corporations that provide end-to-end hardware and software ecosystems:

- Rain Bird Corporation: A leader in central control systems, specifically with their IQ4 platform, which offers cloud connectivity and modularity.
- The Toro Company: Known for integrating autonomous robotics into its portfolio.
- Netafim: A pioneer in drip irrigation and "nutrigation," focusing on uniform water and nutrient delivery.
- Hunter Industries: A major provider of controllers and sensor technology for both residential and commercial applications.
- HydroPoint: A key player focusing on weather-based data and smart water management.

Strategic Consolidation and M&A: The industry is seeing frequent mergers and acquisitions as companies seek to bolster their AgTech portfolios. Notable developments include Lindsay Corporation's acquisition of FieldWise to strengthen its subscription-based precision irrigation offerings and Toro's acquisition of Left Hand Robotics to advance autonomous maintenance solutions.

Major and Innovative Companies: Other significant contributors include Rachio, AquaSpy, Weathermatic, Calsense, and Galcon. These firms often lead in niche innovations, such as soil moisture sensing probes or consumer-friendly WiFi controllers.

### III. Global Technical Insights

Smart irrigation technology is divided into two primary system types based on how they calculate watering requirements.

1. System Architectures

- Weather-Based (Climate-Based) Systems: These systems use evapotranspiration (ET) data to manage schedules. They analyze local temperature, humidity, wind, and solar radiation to determine how much water has been lost by the landscape and must be replaced.
- Sensor-Based Systems: These rely on real-time data from the ground. Soil moisture sensors measure the volumetric water content or tension in the soil, allowing the system to trigger irrigation only when moisture levels fall below a specific threshold.

2. The AI and IoT Revolution: The market is currently being revolutionized by AI-driven systems that move beyond reactive watering to predictive management. Advanced platforms now integrate environmental sensors with artificial intelligence to autonomously monitor soil, crop, and climatic conditions. For example, modern platforms like Rocket 2.0 deliver real-time management that minimizes waste by predicting needs before they occur.

3. Connectivity and Communication Protocols: For IoT development, selecting the right communication protocol is vital:

- LoRaWAN: This is a leading standard for agricultural IoT. It is optimized for battery-powered end-devices and uses a "star-of-stars" topology where gateways relay messages from remote sensors to a central network server.
- WiFi and Cloud: Many modern controllers (like the Rain Bird RC2) use WiFi for residential and commercial applications, allowing users to manage schedules via mobile apps and receive automatic seasonal adjustments based on local weather data.
- SDI-12: This remains a standard serial-digital interface for environmental sensors, facilitating the connection of diverse soil moisture probes to a single data logger or controller.
- APIs: Platforms like IQ4 now offer API integration, allowing irrigation data to be repurposed for third-party work orders and business reporting.

### IV. Core Components for IoT Prototypes

Building a smart irrigation prototype requires integrating several hardware layers:

Sensors

- Soil Moisture Probes: Technologies include TDT (Time Domain Transmission) and capacitance-type sensors (e.g., Ech2o). These measure the dielectric constant of the soil to determine water content.
- Tensiometers: Measure the physical tension roots must exert to extract water, providing a direct measure of water availability.
- Flow and Pressure Sensors: Critical for system health monitoring, detecting leaks, and ensuring the system is operating within its designed hydraulic range.

Controllers: The controller acts as the brain, processing sensor data or weather inputs to trigger valves. Modern units feature modularity, allowing for the addition of extra zones and the management of master valves and pump start relays.

Infrastructure and Delivery

- Dripperlines: These are the delivery mechanisms. "Smart" drippers often include pressure-compensating (PC) mechanisms to ensure uniform flow regardless of elevation changes, and anti-siphon (AS) features to prevent soil ingestion in subsurface systems.
- Solenoid Valves: Hydraulically operated valves that open and close in response to electrical signals from the controller.

### V. Operational Roadmap for Prototype Development

For a project focused on building an IoT prototype, the following logic and maintenance standards should be incorporated:

Calculation Logic: Implement the daily water requirement formula: EVTc = EVTo * Kc.

- EVTo is the reference evapotranspiration (derived from weather data).
- Kc is the crop coefficient, a variable that changes based on the specific crop and its growth stage (germination, vegetative, maturity).

Hydraulic Safety: A professional prototype must account for "water hammer" and surges. This involves using check valves to prevent backflow (especially when injecting nutrients) and air release valves to evacuate air pockets that can damage pipes.

Maintenance Automation: Incorporate automated flushing cycles. Modern systems are designed to flush main lines and dripperlines at regular intervals to remove mineral sedimentation and organic buildup, which is the leading cause of system failure.

Nutrigation Capability: Consider the integration of a dosing unit. Smart systems don't just deliver water; they deliver precise ratios of nutrients (proportional fertigation) based on the current flow rate, often monitored through EC (electrical conductivity) and pH sensors.
