flashdato/Bachelor_Project/Firmware/CubeIDE_Workspaces/Smart Flow 2.0 Sensor Module/Core/Src/main.c

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
/* Includes ------------------------------------------------------------------*/
#include "main.h"

/* USER CODE BEGIN Includes */
#include "string.h"
#include "stdio.h"
#include <stdbool.h>
#include <math.h>
/* USER CODE END Includes */

ADC_HandleTypeDef hadc1;

TIM_HandleTypeDef htim2;

UART_HandleTypeDef huart1;
UART_HandleTypeDef huart3;

/* USER CODE BEGIN PV */
uint8_t rxData;

//Bluetooth
uint8_t rxData;
uint8_t rx_buffer[100] = { 0 };
uint8_t rx_index = 0;
int len;
char buffer[100];

//sensors
uint16_t readValue1;
uint16_t readValue2;
ADC_ChannelConfTypeDef sConfigPrivate = { 0 };

//TDS
int analogBuffer[30];
int analogBufferIndex = 0;
float tdsValue = 0;
char TDSstring[5];
float tdsValue_User = 0;
int tdsIntervalM = 0;
int tdsInt = 0;

//Preasure
float preasure = 0;
char preasureString[5];

//PH
float ph = 0;
char phString[5];
float calibration_value = 27.34;
int phval = 0;
unsigned long int avgval;
int ph_buffer_arr[10], temp;
int phBufferIndex = 0;

//Time
int second, minute, hour;
int interval, interval1, interval2, interval3, interval4, intervalT;

//Sequence
int sequence = 0;

char intString[5];
int integerValue;

//RELAYS
bool relay1;
bool relay2;
bool relay3;
bool relay4;
bool relay5;
bool relay6;
bool relay7;
bool relay8;
bool relay9;
bool relay10;
bool relay11;

/* USER CODE END PV */

void SystemClock_Config(void);
static void MX_GPIO_Init(void);
static void MX_ADC1_Init(void);
static void MX_USART1_UART_Init(void);
static void MX_USART3_UART_Init(void);
static void MX_TIM2_Init(void);
/**
 * @brief  The application entry point.
 * @retval int
 */
int main(void) {
	/* USER CODE BEGIN 1 */
	float calculateAverageVoltage() {
		long sum = 0;
		for (int i = 0; i < 30; i++) {
			sum += analogBuffer[i];
		}
		return (float) sum / 30 / 1200.0;
	}

	float calculateCompensationCoefficient() {
		float temperature = 19;  // Default temperature (adjust as needed)
		return 1.0 + 0.02 * (temperature - 25.0);
	}

	float calculateTDS(float voltage, float coefficient) {
		float tds = (170.42 * voltage * voltage * voltage
				- 253.86 * voltage * voltage + 850.39 * voltage) * 0.5
				/ coefficient;
		return tds / 500; // Adjust this factor as needed
	}
	void floatToParts(float value, char *TDSstring) {
		int integerPart = (int) value;
		int decimalPart = (int) (value * pow(10, 4)) % (int) pow(10, 4);

		// Convert the integer part to a string
		char intString[10];
		sprintf(intString, "%d", integerPart);

		// Convert the decimal part to a string
		char decString[10];
		sprintf(decString, "%0*d", 4, decimalPart);

		// Combine the integer and decimal parts into TDSstring
		strcpy(TDSstring, intString);
		strcat(TDSstring, decString);
	}
	float readPhSensor() {
//		for (int i = 0; i < 9; i++) {
//			for (int j = i + 1; j < 10; j++) {
//				if (buffer_arr[i] > buffer_arr[j]) {
//					temp = buffer_arr[i];
//					buffer_arr[i] = buffer_arr[j];
//					buffer_arr[j] = temp;
//				}
//			}
//		}

		avgval = 0;
		for (int i = 2; i < 8; i++)
			avgval += ph_buffer_arr[i];

		return -5.70 * avgval * 5.0 / 4096 / 6 + calibration_value;

	}
	/* USER CODE END 1 */

	/* MCU Configuration--------------------------------------------------------*/

	/* Reset of all peripherals, Initializes the Flash interface and the Systick. */
	HAL_Init();

	/* Configure the system clock */
	SystemClock_Config();

	/* Initialize all configured peripherals */
	MX_GPIO_Init();
	MX_ADC1_Init();
	MX_USART1_UART_Init();
	MX_USART3_UART_Init();
	MX_TIM2_Init();
	/* USER CODE BEGIN 2 */
	HAL_TIM_Base_Start_IT(&htim2);
	HAL_UART_Receive_IT(&huart1, &rxData, 1);
	HAL_UART_Receive_IT(&huart3, &rxData, 1);
	/* USER CODE END 2 */

	/* Infinite loop */
	/* USER CODE BEGIN WHILE */
	while (1) {
		sConfigPrivate.Rank = ADC_REGULAR_RANK_1;
		sConfigPrivate.SamplingTime = ADC_SAMPLETIME_1CYCLE_5;
		sConfigPrivate.Channel = ADC_CHANNEL_0;
		HAL_ADC_ConfigChannel(&hadc1, &sConfigPrivate);
		HAL_ADC_Start(&hadc1);
		HAL_ADC_PollForConversion(&hadc1, 1000);
		readValue1 = HAL_ADC_GetValue(&hadc1);
		HAL_ADC_Stop(&hadc1);
		sConfigPrivate.Channel = ADC_CHANNEL_1;
		HAL_ADC_ConfigChannel(&hadc1, &sConfigPrivate);
		HAL_ADC_Start(&hadc1);
		HAL_ADC_PollForConversion(&hadc1, 1000);
		readValue2 = HAL_ADC_GetValue(&hadc1);
		HAL_ADC_Stop(&hadc1);

		preasure = (((readValue2 * 5) / 1024) - 0.483) * 250;

		ph_buffer_arr[phBufferIndex] = readValue2;
		phBufferIndex = (phBufferIndex + 1) % 10;

		//ph = readPhSensor(); //ar gvinda memgoni aq gadaqceva ha ras ityv?
		ph = 7.0;

		analogBuffer[analogBufferIndex] = readValue1;
		analogBufferIndex = (analogBufferIndex + 1) % 30;

		tdsValue = calculateTDS(calculateAverageVoltage(),
				calculateCompensationCoefficient());
		floatToParts(tdsValue, TDSstring);
		//floatToParts(preasure, preasureString);
		floatToParts(ph, phString);
		if (tdsValue_User > 1) {
			tdsValue_User = -1;
		}
		/* USER CODE END WHILE */

		/* USER CODE BEGIN 3 */
	}
	/* USER CODE END 3 */
}

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
/* USER CODE BEGIN 4 */
void HAL_TIM_PeriodElapsedCallback(TIM_HandleTypeDef *htim) {
	if (htim->Instance == TIM2) {
		if (interval > 0) {
			interval--;
		}
		second++;
		if (second == 60) {
			second = 0;
			minute++;
		}
		if (minute == 60) {
			minute = 0;
			hour++;
		}
		if (hour == 24) {
			hour = 0;
		}

		if (intervalT > 0) {
			intervalT--;
		}

		if (sequence == 3 || sequence == 6 || sequence == 9 || sequence == 12) {
			if (tdsValue > 1.3 && intervalT == 0) {
				sprintf(buffer, "M0 \r\n");
				len = strlen(buffer);
				HAL_UART_Transmit(&huart1, buffer, len, 100);
				intervalT = 2;
			} else if (tdsValue < 1 && intervalT == 0) {
				sprintf(buffer, "M1 \r\n");
				len = strlen(buffer);
				HAL_UART_Transmit(&huart1, buffer, len, 100);
				intervalT = 2;
			} else if (tdsValue < 1.3 && tdsValue > 1) {
				intervalT = 2;
			}
		}

		if (sequence == 1) {
			sprintf(buffer, "101 \r\n");
			len = strlen(buffer);
			HAL_UART_Transmit(&huart1, buffer, len, 100);
			sprintf(buffer, "101 \r\n");
			len = strlen(buffer);
			HAL_UART_Transmit(&huart1, buffer, len, 100);
			interval = 5;
			if (relay3) {
				sprintf(buffer, "103 \r\n"); // Format the string for relay3 == true
			} else if (relay4) {
				sprintf(buffer, "104 \r\n"); // Format the string for relay4 == true
			} else if (relay5) {
				sprintf(buffer, "105 \r\n"); // Format the string for relay5 == true
			} else if (relay6) {
				sprintf(buffer, "106 \r\n"); // Format the string for relay6 == true
			} else if (relay7) {
				sprintf(buffer, "107 \r\n"); // Format the string for relay7 == true
			} else if (relay8) {
				sprintf(buffer, "108 \r\n"); // Format the string for relay8 == true
			} else if (relay9) {
				sprintf(buffer, "109 \r\n"); // Format the string for relay9 == true
			} else if (relay10) {
				sprintf(buffer, "110 \r\n"); // Format the string for relay10 == true
			} else if (relay11) {
				sprintf(buffer, "111 \r\n"); // Format the string for relay11 == true
			}
			len = strlen(buffer);
			HAL_UART_Transmit(&huart1, buffer, len, 100);
			sequence = 2;
		}
		if (sequence == 2 && interval == 0) {
			interval = interval1;
			sprintf(buffer, "102 \r\n");
			len = strlen(buffer);
			HAL_UART_Transmit(&huart1, buffer, len, 100);
			sequence = 3;
		}
		if (sequence == 3 && interval == 0) {
			interval = 5;
			sprintf(buffer, "002 \r\n");
			len = strlen(buffer);
			HAL_UART_Transmit(&huart1, buffer, len, 100);
			len = strlen(buffer);
			sequence = 4;
		}
		if (sequence == 4 && interval == 0) {
			interval = 5;
			if (relay3) {
				sprintf(buffer, "003 \r\n"); // Format the string for relay3 == true
				relay3 = false;
			} else if (relay4) {
				sprintf(buffer, "004 \r\n"); // Format the string for relay4 == true
				relay4 = false;
			} else if (relay5) {
				sprintf(buffer, "005 \r\n"); // Format the string for relay5 == true
				relay5 = false;
			} else if (relay6) {
				sprintf(buffer, "006 \r\n"); // Format the string for relay6 == true
				relay6 = false;
			} else if (relay7) {
				sprintf(buffer, "007 \r\n"); // Format the string for relay7 == true
				relay7 = false;
			} else if (relay8) {
				sprintf(buffer, "008 \r\n"); // Format the string for relay8 == true
				relay8 = false;
			} else if (relay9) {
				sprintf(buffer, "009 \r\n"); // Format the string for relay9 == true
				relay9 = false;
			} else if (relay10) {
				sprintf(buffer, "010 \r\n"); // Format the string for relay10 == true
				relay10 = false;
			} else if (relay11) {
				sprintf(buffer, "011 \r\n"); // Format the string for relay11 == true
				relay11 = false;
			}
			len = strlen(buffer);
			HAL_UART_Transmit(&huart1, buffer, len, 100);
			if (relay3) {
				sprintf(buffer, "103 \r\n"); // Format the string for relay3 == true
			} else if (relay4) {
				sprintf(buffer, "104 \r\n"); // Format the string for relay4 == true
			} else if (relay5) {
				sprintf(buffer, "105 \r\n"); // Format the string for relay5 == true
			} else if (relay6) {
				sprintf(buffer, "106 \r\n"); // Format the string for relay6 == true
			} else if (relay7) {
				sprintf(buffer, "107 \r\n"); // Format the string for relay7 == true
			} else if (relay8) {
				sprintf(buffer, "108 \r\n"); // Format the string for relay8 == true
			} else if (relay9) {
				sprintf(buffer, "109 \r\n"); // Format the string for relay9 == true
			} else if (relay10) {
				sprintf(buffer, "110 \r\n"); // Format the string for relay10 == true
			} else if (relay11) {
				sprintf(buffer, "111 \r\n"); // Format the string for relay11 == true
			}
			len = strlen(buffer);
			HAL_UART_Transmit(&huart1, buffer, len, 100);
			sequence = 5;
		}
		if (sequence == 5 && interval == 0) {
			interval = interval2;
			sprintf(buffer, "102 \r\n");
			len = strlen(buffer);
			HAL_UART_Transmit(&huart1, buffer, len, 100);
			sequence = 6;
		}
		if (sequence == 6 && interval == 0) {
			interval = 5;
			sprintf(buffer, "002 \r\n");
			len = strlen(buffer);
			HAL_UART_Transmit(&huart1, buffer, len, 100);
			sequence = 7;
		}
		if (sequence == 7 && interval == 0) {
			interval = 5;
			if (relay3) {
				sprintf(buffer, "003 \r\n"); // Format the string for relay3 == true
				relay3 = false;
			} else if (relay4) {
				sprintf(buffer, "004 \r\n"); // Format the string for relay4 == true
				relay4 = false;
			} else if (relay5) {
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
//			sprintf(buffer, "109 \r\n");
//			len = strlen(buffer);
//			HAL_UART_Transmit(&huart1, buffer, len, 100);
//			rx_index = 0;
//			memset(rx_buffer, 0, sizeof(rx_buffer));
//		} else if (strstr((char*) rx_buffer, "010")) {
//			sprintf(buffer, "010 \r\n");
//			len = strlen(buffer);
//			HAL_UART_Transmit(&huart1, buffer, len, 100);
//			rx_index = 0;
//			memset(rx_buffer, 0, sizeof(rx_buffer));
//		} else if (strstr((char*) rx_buffer, "110")) {
//			sprintf(buffer, "110 \r\n");
//			len = strlen(buffer);
//			HAL_UART_Transmit(&huart1, buffer, len, 100);
//			rx_index = 0;
//			memset(rx_buffer, 0, sizeof(rx_buffer));
//		} else if (strstr((char*) rx_buffer, "011")) {
//			sprintf(buffer, "011 \r\n");
//			len = strlen(buffer);
//			HAL_UART_Transmit(&huart1, buffer, len, 100);
//			rx_index = 0;
//			memset(rx_buffer, 0, sizeof(rx_buffer));
//		} else if (strstr((char*) rx_buffer, "111")) {
//			sprintf(buffer, "111 \r\n");
//			len = strlen(buffer);
//			HAL_UART_Transmit(&huart1, buffer, len, 100);
//			rx_index = 0;
//			memset(rx_buffer, 0, sizeof(rx_buffer));
		} else if (strstr((char*) rx_buffer, "999")) {

			sprintf(buffer, "%s%s\n", TDSstring, phString);
			len = strlen(buffer);
			HAL_UART_Transmit(&huart3, buffer, len, 100);
			rx_index = 0;
			memset(rx_buffer, 0, sizeof(rx_buffer));
		} else if (strstr((char*) rx_buffer, "801")) {
			sequence = 1;
			rx_index = 0;
			memset(rx_buffer, 0, sizeof(rx_buffer));
		} else if (rx_buffer[0] == 'S') {
			strncpy(intString, &rx_buffer[2], 4); // Copy the characters to intString
			intString[4] = '\0'; // Null-terminate the string
			integerValue = atoi(intString);
			if (rx_buffer[1] == '1') {
				interval1 = integerValue;
			} else if (rx_buffer[1] == '2') {
				interval2 = integerValue;
			} else if (rx_buffer[1] == '3') {
				interval3 = integerValue;
			} else if (rx_buffer[1] == '4') {
				interval4 = integerValue;
			} else if (rx_buffer[1] == '5') {
				interval1 = integerValue;
			}
			rx_index = 0;
			memset(intString, 0, sizeof(intString));
			memset(rx_buffer, 0, sizeof(rx_buffer));
		} else if (rx_buffer[0] == 'E') {
			strncpy(intString, &rx_buffer[1], 4); // Copy the characters to intString
			intString[4] = '\0'; // Null-terminate the string
			integerValue = atoi(intString);
			tdsValue_User = integerValue / 1000;
			rx_index = 0;
			memset(intString, 0, sizeof(intString));
			memset(rx_buffer, 0, sizeof(rx_buffer));
		} else if (rx_buffer[0] == 'R') {
			strncpy(intString, &rx_buffer[1], 2); // Copy the characters to intString
			intString[2] = '\0'; // Null-terminate the string
			integerValue = atoi(intString);
			relay3 = (integerValue == 3) ? true : relay3;
			relay4 = (integerValue == 4) ? true : relay4;
			relay5 = (integerValue == 5) ? true : relay5;
			relay6 = (integerValue == 6) ? true : relay6;
			relay7 = (integerValue == 7) ? true : relay7;
			relay8 = (integerValue == 8) ? true : relay8;
			relay9 = (integerValue == 9) ? true : relay9;
			relay10 = (integerValue == 10) ? true : relay10;
			relay11 = (integerValue == 11) ? true : relay11;
			rx_index = 0;
			memset(intString, 0, sizeof(intString));
			memset(rx_buffer, 0, sizeof(rx_buffer));
		} else {
			rx_index = 0;
			memset(rx_buffer, 0, sizeof(rx_buffer));
		}

		HAL_UART_Receive_IT(&huart3, &rxData, 1);

	}
}
/* USER CODE END 4 */
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
