flashdato/Bachelor_Project/Firmware/CubeIDE_Workspaces/Smart Flow 2.0 Sensor Module/Smart Flow 2.0 Sensor Module.ioc

Mcu.UserName=STM32F103C8Tx
PA0-WKUP.Signal=ADCx_IN0
PA1.Signal=ADCx_IN1
PA10.Signal=USART1_RX
PA13.Signal=SYS_JTMS-SWDIO
PA14.Signal=SYS_JTCK-SWCLK
PA9.Signal=USART1_TX
PB10.Signal=USART3_TX
PB11.Signal=USART3_RX
PD0-OSC_IN.Signal=RCC_OSC_IN
PD1-OSC_OUT.Signal=RCC_OSC_OUT
