flashdato/Bachelor_Project/(notices)

Notices in the files:
Firmware/CubeIDE_Workspaces/Smart Flow 2.0 Sensor Module/Core/Src/main.c:
Copyright (c) 2023 STMicroelectronics.
All rights reserved.
This software is licensed under terms that can be found in the LICENSE file
